laurencebarker/Saturn-power-manager/documentation/prototype photo.jpg

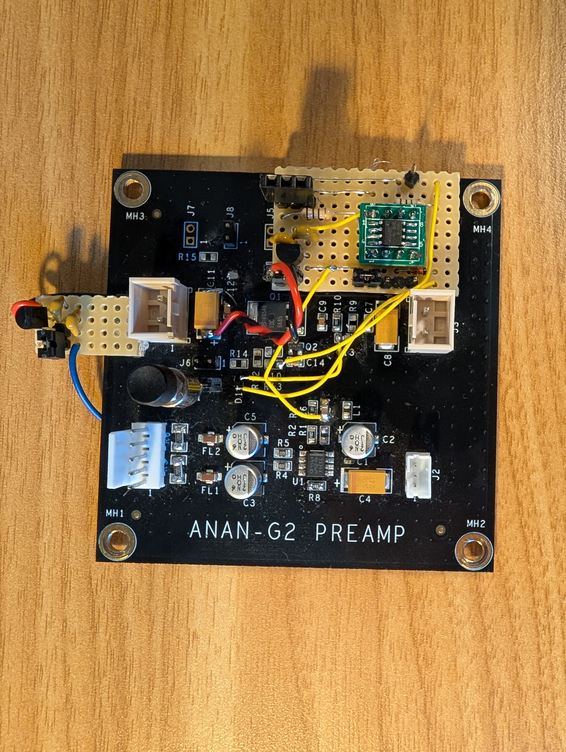
documentation/prototype photo.jpg
