laurencebarker/Saturn-power-manager/README.md

# Saturn G2 Power manager
Microcontroller for power switch board

This can be programmed with a UPDI programmer, easily made from an Arduino Nano: see for example https://daumemo.com/diy-updi-usb-programmer-which-can-be-made-with-cheap-hardware/
