laurencebarker/Saturn-power-manager/documentation/power manager simple schematic.drawio.png

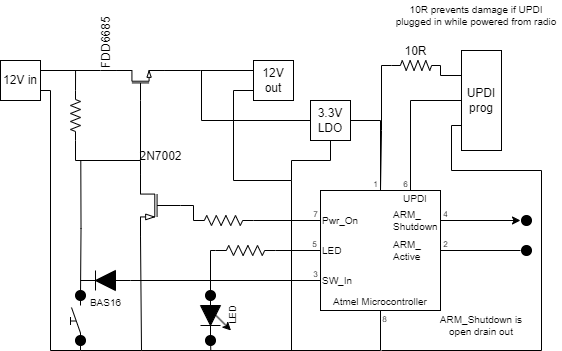
documentation/power manager simple schematic.drawio.png
