laurencebarker/Saturn-power-manager/documentation/power manager simple schematic.png

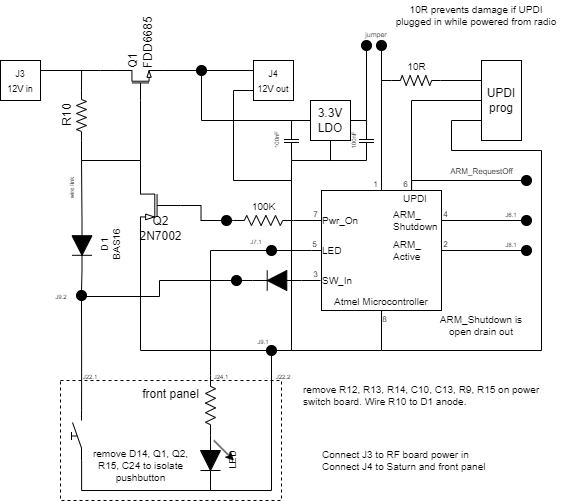
documentation/power manager simple schematic.png
