laurencebarker/Saturn-power-manager/documentation/power manager state diagram.png

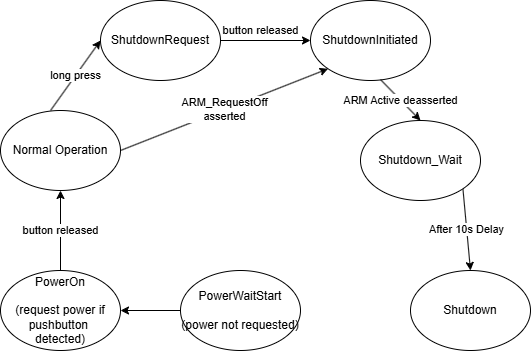
documentation/power manager state diagram.png
