laurencebarker/Saturn-power-manager/(commit log)

2025-03-01 added ability for AREM to request shutdown too
    UPDI pin can be used as a power off request trigger
2025-06-27 code changed to avoid "power back on" glitch
    when warm, the radio sometimes powered straight back on when it was shutting down.
    microcontroller code changed to only assert to "hold power on" output in the startup state if the pushbutton detected pressed.
    (In shutdown, the pushbutton input would not be 0)
    [powersketch.ino]
2025-06-27 more robust operation
    waits 0.2s before even considering applying power lock.
2025-07-30 added initial morse blink
    Blinks "G2" at startup so that the power manager can be identified as present
